kevcasta98/ACE2_2S_G13/F1/firmware/PORTUS_Fase1/control_central.h

// control_central.h
#ifndef CONTROL_CENTRAL_H
#define CONTROL_CENTRAL_H
#include "modelos.h"

void inicializarControlCentral();
void actualizarControlCentral();

// útiles para la consola de supervisión
int totalTurnosActivos();
Turno obtenerTurno(int indice);
#endif
