kevcasta98/ACE2_2S_G13/F1/firmware/PORTUS_Fase1/cola_grua.cpp

// cola_grua.cpp
#include "cola_grua.h"

void inicializarColaGrua() {}
void encolarTrabajo(TrabajoGrua trabajo) {}
bool hayTrabajoPendiente() { return false; }
TrabajoGrua obtenerSiguienteTrabajo()
{
    TrabajoGrua vacio = {TRABAJO_DEPOSITO, -1, -1, -1};
    return vacio;
}
void completarTrabajoActual() {}
