kevcasta98/ACE2_2S_G13/F1/firmware/PORTUS_Fase1/inventario.cpp

// inventario.cpp
#include "inventario.h"

void inicializarInventario() {}
EstadoPosicion estadoDePosicion(int posicion) { return POS_LIBRE; }
int buscarPosicionLibre() { return -1; }
void reservarPosicion(int posicion) {}
void confirmarOcupacion(int posicion, String idContenedor) {}
void liberarPosicion(int posicion) {}
void marcarBloqueada(int posicion) {}
