kevcasta98/ACE2_2S_G13/F1/firmware/PORTUS_Fase1/transferencia.cpp

// transferencia.cpp
#include "transferencia.h"
void inicializarTransferencia() {}
void actualizarTransferencia() {}
bool zonaTransferenciaOcupada() { return false; }
bool camionDetectadoEnTransferencia() { return false; }
