kevcasta98/ACE2_2S_G13/F1/firmware/PORTUS_Fase1/transferencia.h

// transferencia.h
#ifndef TRANSFERENCIA_H
#define TRANSFERENCIA_H
void inicializarTransferencia();
void actualizarTransferencia();
bool zonaTransferenciaOcupada();
bool camionDetectadoEnTransferencia();
#endif
