kevcasta98/ACE2_2S_G13/(commit log)

2026-08-26 Esqueleto base del rpoyecto, estructura de carpetas y archivos
2026-08-28 Pruebas del RFID para verificar que si funcionan los modulos
2026-08-29 Codigo para las luces, talanqueras y sensores
2026-09-26 Backend de Fase 2 subida y completada
